cliffgraph/MGSPICO3/MGSPICO3-xxx/partslist_MGSPICO3-01D.xlsx

MGSPICO3-01D |  |  |  |  |  |  | 2024-10-11
Reference | Qty | Value
C1, C8, C11 | 3 | 100uF |  | 電解コンデンサー100μF25V105℃ ルビコンPX | 秋月電子 | 117877 | https://akizukidenshi.com/catalog/g/g117877/
C2, C16 | 1 | 10uF/25V | UES1E100MDM | MUSE ESシリーズ 両極性 アルミ電解コンデンサ 25V 10μF | 千石電商 |  | https://www.sengoku.co.jp/mod/sgk_cart/detail.php?code=5BED-RPKE
C3, C5 | 2 | 22uF | 20SEP22M | 導電性高分子固体電解コンデンサ(OS-CON) 20V 22μF | 千石電商 |  | https://www.sengoku.co.jp/mod/sgk_cart/detail.php?code=8AGN-NUHR
C4, C6, C12, C17 | 3 | 104 | GRM31C5C2A104JA01 | チップ積層セラミックコンデンサー 0.1μF100V C0G 3216 | 秋月電子 | 115180 | https://akizukidenshi.com/catalog/g/g115180/
C7 | 1 | 1000pF | 2A-UPZ-102JE | ポリプロピレンフィルムコンデンサ 100V1000pF | 千石電商 |  | https://www.sengoku.co.jp/mod/sgk_cart/detail.php?code=EEHD-0FTL
C9 | 1 | 330uF/16V | 1CUTSJ331M0 | 音響用ハイグレード電解コンデンサ 16V 330μF | 千石電商 |  | https://www.sengoku.co.jp/mod/sgk_cart/detail.php?code=4ATD-NTHT
C10 | 1 | 106 | RD20F106Z1EH5L | 絶縁ラジアルリード型積層セラミックコンデンサー 10μF25V5mmピッチ | 秋月電子 | 103095 | https://akizukidenshi.com/catalog/g/g103095/
C13 | 1 | 476 | GRM32EC81C476KE15L | チップ積層セラミックコンデンサー 47μF16V X6S 3225 | 秋月電子 | 116078 | https://akizukidenshi.com/catalog/g/g116078/
C14, C15 | 2 | 105 | GRM21BC72A105KE01 | チップ積層セラミックコンデンサー 1μF100V X7S 2012 | 秋月電子 | 113699 | https://akizukidenshi.com/catalog/g/g113699/
IC1 | 1 | ADP151AUJZ-3.3-R7 | ADP151AUJZ-3.3 | 超低ノイズ低損失CMOSレギュレーター 3.3V200mA ADP151AUJZ-3.3 | 秋月電子 | 114180 | https://akizukidenshi.com/catalog/g/g114180/
IC2 | 1 | PLT133_T10W | PLT133/T10W | 角型光デジタル通信コネクター(送信用・シャッター付) PLT133/T10W | 秋月電子 | 109598 | https://akizukidenshi.com/catalog/g/g109598/
J1 | 1 | MJ-179PH(Center+) | MJ-179PH | 2.1mm標準DCジャック(4A) 基板取付用 MJ-179PH | 秋月電子 | 106568 | https://akizukidenshi.com/catalog/g/g106568/
J2, J4, J5, J6, J7, J8 | 5 | TestPin | TEST-22 | チェック端子(テストポイント) TEST-22 ★★★実装の必要はありません。 | 秋月電子 | 112216 | https://akizukidenshi.com/catalog/g/g112216/
J3 | 1 | AudioJack3 | ST-005-G | 3.5mm小型ステレオミニジャック 基板取付用 | 秋月電子 | 102460 | https://akizukidenshi.com/catalog/g/g102460/
JP1, JP2 | 2 | Jumper | PH-1x40SG | ピンヘッダー 1×40 (40P) ★２ピンごとに切り離して使用する★ピンヘッダーを使用せずに、抵抗の足などを直接ハンダ付けでもOKです | 秋月電子 | 100167 | https://akizukidenshi.com/catalog/g/g100167/
L1 | 1 | 4.7uH | RTP8010-4R3-N | デジタルアンプ用インダクタ(リード型)4.3μH | マルツオンライン |  | https://www.marutsu.co.jp/GoodsDetail.jsp?q=RTP8010-4R3&salesGoodsCode=68082&shopNo=3
PS1 | 1 | MCW03-05S05 | MCW03-05S05 | 3W級絶縁型DC-DCコンバーター(5V600mA)MCW03-05S05 | 秋月電子 | 104261 | https://akizukidenshi.com/catalog/g/g104261/
 |  | ソケット | PH-1x40SG | ピンヘッダー 1×40 (40P)、★ソケットを使用せず、MCW03-05S05を直接実装してもOKです | 秋月電子 | 100167 | https://akizukidenshi.com/catalog/g/g100167/
R1 | 1 | 1K | 1KΩ、1/4W or 1/2W | 小型 金属皮膜抵抗 1kΩ
R2, R3 | 3 | 10K | 10KΩ、1/4W or 1/2W | 小型 金属皮膜抵抗 10kΩ
R4 | 1 | 4.7K | 4.7KΩ、1/4W or 1/2W | 小型 金属皮膜抵抗 4.7kΩ
R5 | 1 | 47 | 47Ω、1/4W or 1/2W | 小型 金属皮膜抵抗 47kΩ
R6 | 1 | 10K | RK73B2BTTD103J | 3216(1206)チップ抵抗 10KΩ | 千石電商 |  | https://www.sengoku.co.jp/mod/sgk_cart/detail.php?code=EEHD-0ED7
S1 | 1 | TVDP01-G73BB | TVDP01-G73BB with Red cap | タクトスイッチ TVDP01-G73BB(赤) | 秋月電子 | 109825 | https://akizukidenshi.com/catalog/g/g109825
S2, S3 | 2 | TVDP01-G73BB | TVDP01-G73BB with Black cap | タクトスイッチ TVDP01-G73BB(黒) | 秋月電子 | 109824 | https://akizukidenshi.com/catalog/g/g109824/
U1 | 1 | AE-Si5351A-B | AE-Si5351A-B | 3ch出力プログラマブル周波数ジェネレーターモジュール Si5351A使用 | 秋月電子 | 110679 | https://akizukidenshi.com/catalog/g/g110679/
 | 1 | ソケット | 2227MC-08-03 | 丸ピンICソケット ( 8P) | 秋月電子 | 100035 | https://akizukidenshi.com/catalog/g/g100035/
U2 | 1 | NJM4580 | NJM4580DD | 2回路入HiFiオペアンプ ローノイズ選別品 NJM4580DD | 秋月電子 | 100069 | https://akizukidenshi.com/catalog/g/g100069/
 | 1 | ソケット | 2227MC-08-03 | 丸ピンICソケット ( 8P) | 秋月電子 | 100035 | https://akizukidenshi.com/catalog/g/g100035/
U3 | 1 | Pico2 | SC1631 | Raspberry Pi Pico 2 | 秋月電子 | 129604 | https://akizukidenshi.com/catalog/g/g129604/
U4 | 1 | OLED 128x64 |  | 0.96インチ 128×64ドット有機ELディスプレイ(OLED) 白色 | 秋月電子 | 112031 | https://akizukidenshi.com/catalog/g/g112031/
 | 1 | ソケット | 2212S-14G-36 | シングルピンソケット (低メス) 1×14 (14P) ★ソケットを使用せず、MCW03-05S05を直接実装してもOKです | 秋月電子 | 112179 | https://akizukidenshi.com/catalog/g/g112179/
U5 | 1 | TangNano9K | Tang Nano 9K | Tang Nano 9K | 秋月電子 | 117448 | https://akizukidenshi.com/catalog/g/g117448/
 | 2 | ソケット | 6604S-40 | 丸ピンIC用ソケット (シングル40P) 1×40 ★24ピンを２本作成する | 秋月電子 | 101591 | https://akizukidenshi.com/catalog/g/g101591/
 | 2 | ICピン | 6604P-40G-121 | 丸ピンIC用連結ソケット(両端オスピン・1列40P) ★24ピンを２本作成し、TangNano9K付属ピンの代わりに使用する | 秋月電子 | 101382 | https://akizukidenshi.com/catalog/g/g101382/
U6 | 1 | DAC PT8211 | PT8211-S-TP | 16bit2chDAコンバーター PT8211 | 秋月電子 | 117061 | https://akizukidenshi.com/catalog/g/g117061/
VR1 | 1 | GF063PB103K | 3362P-1-103LF | 半固定ボリューム 3362P 10kΩ [103] | 秋月電子 | 103277 | https://akizukidenshi.com/catalog/g/g103277/
