cliffgraph/MGSPICO3/MGSPICO3-xxx/schematic_MGSPICO3-01D.pdf

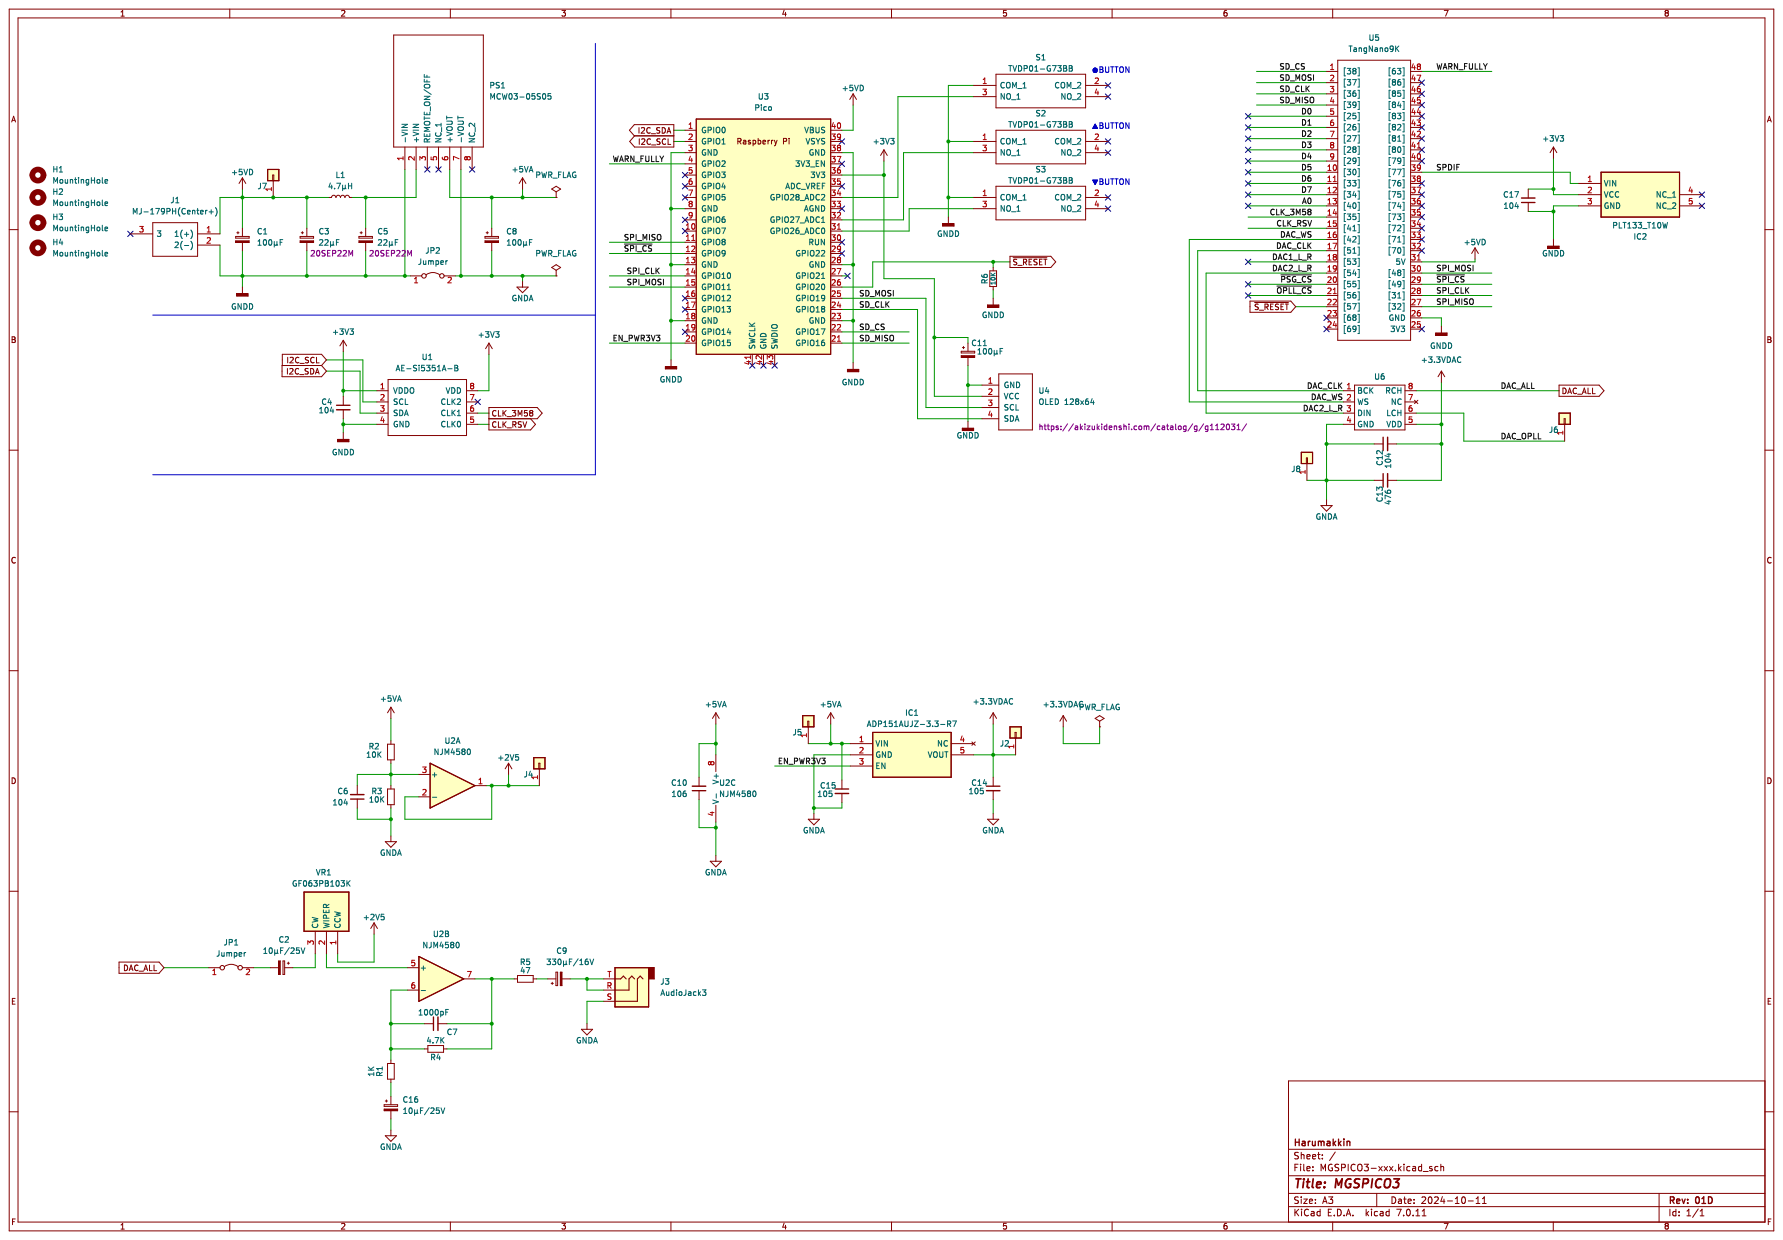
[picture p2: page 1]
