cliffgraph/MGSPICO3/TangNano9K/src/WTS/scc_for_mgspico3.v

// ------------------------------------------------------------------------------------------------
// Wave Table Sound
// Copyright 2021 t.hara
// 
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
module scc_for_mgspico3 (
	input			clk,			//	21.47727MHz
	input			slot_nreset,	//	negative logic
	input	[14:0]	slot_a,
	input	[7:0]	slot_d,
	input			slot_nwr,		//	negative logic
	output	[10:0]	sound_out		//	digital sound output (11 bits)
);
	reg				ff_nwr1;
	reg				ff_nwr2;
	wire			w_wrreq;
	wire			w_rdreq;

	always @( negedge slot_nreset or posedge clk ) begin
		if( !slot_nreset ) begin
			ff_nwr1 <= 1'b1;
			ff_nwr2 <= 1'b1;
		end
		else begin
			ff_nwr1 <= slot_nwr;
			ff_nwr2 <= ff_nwr1;
		end
	end

	assign w_wrreq			= ~ff_nwr1 & ff_nwr2;

	scc_core #(
		.add_offset			( 1					)
	) u_scc_core (
		.nreset				( slot_nreset		),
		.clk				( clk				),
		.wrreq				( w_wrreq			),
		.rdreq				( 1'b0				),
		.wr_active			( 1'b1				),
		.rd_active			( 1'b0				),
		.a					( slot_a			),
		.d					( slot_d			),
		.q					( ),
		.mem_ncs			( ),
		.mem_a				( ),
		.left_out			( sound_out			)
	);
endmodule
