cliffgraph/MGSPICO3/(commit log)

2024-10-12 first commit.
    [device.cfg, partslist_MGSPICO3-01D.xlsx]
2024-10-27 TangNano9K:Improved metastable protection circuit.
